nilaynagh8-del/Customizable-PCB-Badge/PCB/Custom PCB Badge.kicad_pcb

## KiCad design PCB/Custom PCB Badge.kicad_pcb (2026-10-25)

Schematic: Custom PCB Badge.kicad_sch

Parts:
C1, C2, C3, C4, C5, C6, C7, C8, C9, C10, C11, C12, C17: 0.1uf; C_0402_1005Metric_Pad0.74x0.62mm_HandSolder
C13, C14, C18: 10uf; C_0603_1608Metric_Pad1.08x0.95mm_HandSolder
C15, C16: 15pf; C_0402_1005Metric_Pad0.74x0.62mm_HandSolder
J1: USB_C_Receptacle_USB2.0_14P; USB_C_Receptacle_HRO_TYPE-C-31-M-12
J3: Conn_01x15_MountingPin; PinHeader_1x15_P2.54mm_Vertical
J8: Conn_01x11_MountingPin; PinHeader_1x11_P2.54mm_Vertical
R1: 5.1K; R_0402_1005Metric_Pad0.72x0.64mm_HandSolder
R2: 5.1k; R_0402_1005Metric_Pad0.72x0.64mm_HandSolder
R3, R4: 27; R_0402_1005Metric_Pad0.72x0.64mm_HandSolder
R5, R6: 1k; R_0402_1005Metric_Pad0.72x0.64mm_HandSolder
R7: 10k; R_0402_1005Metric_Pad0.72x0.64mm_HandSolder
SW1: SW_Push; SW_Push_1P1T_NO_CK_KMR2
U1: RP2040; QFN-56-1EP_7x7mm_P0.4mm_EP3.2x3.2mm
U2: NCP1117-3.3_SOT223; SOT-223-3_TabPin2
U3: W25Q128JVS; SOIC-8_5.3x5.3mm_P1.27mm
Y1: 12mhz; Crystal_SMD_3225-4Pin_3.2x2.5mm_HandSoldering

Connections:
+1V1: C10.1, C11.1, C12.1, U1.43 (ADC_AVDD), U1.48 (USB_VDD)
+3V3: C1.1, C2.1, C3.1, C4.1, C5.1, C6.1, C7.1, C8.1, C9.1, C14.1, C17.1, J3.5, J8.5, R7.1, U1.1 (IOVDD), U1.10 (IOVDD), U1.22 (IOVDD), U1.23 (DVDD), U1.33 (IOVDD), U1.42 (IOVDD), U1.44 (VREG_VIN), U1.45 (VREG_VOUT), U1.49 (IOVDD), U1.50 (DVDD), U2.2 (VO), U3.8 (VCC); also elsewhere on the board
+5V: C13.1, C18.1, J1.A4 (VBUS), J1.A9 (VBUS), J1.B4 (VBUS), J1.B9 (VBUS), J3.1, J8.1, U2.3 (VI)
/d+: J1.A6 (D+), J1.B6 (D+), R3.1
/d-: J1.A7 (D-), J1.B7 (D-), R4.1
/xin: C16.2, U1.20 (XIN), Y1.3
/xout: R5.2, U1.21 (XOUT)
GND: C1.2, C2.2, C3.2, C4.2, C5.2, C6.2, C7.2, C8.2, C9.2, C10.2, C11.2, C12.2, C13.2, C14.2, C15.1, C16.1, C17.2, C18.2, J1.A1 (GND), J1.A12 (GND), J1.B1 (GND), J1.B12 (GND), J1.SH (SHIELD), J3.3, J3.8, J3.13, J8.3, J8.8, J8.10, R1.2, R2.1, SW1.1, U1.19 (TESTEN), U1.57 (GND), U2.1 (GND), U3.4 (GND), Y1.2 (G), Y1.4 (G); also elsewhere on the board
GPIO0: J3.2, U1.2 (GPIO0)
GPIO1: J3.4, U1.3 (GPIO1)
GPIO2: J3.6, U1.4 (GPIO2)
GPIO3: J3.7, U1.5 (GPIO3)
GPIO4: J3.9, U1.6 (GPIO4)
GPIO5: J3.10, U1.7 (GPIO5)
GPIO6: J3.11, U1.8 (GPIO6)
GPIO7: J3.12, U1.9 (GPIO7)
GPIO8: J3.14, U1.11 (GPIO8)
GPIO9: J3.15, U1.12 (GPIO9)
GPIO10: U1.13 (GPIO10); also elsewhere on the board
GPIO11: U1.14 (GPIO11); also elsewhere on the board
GPIO12: U1.15 (GPIO12); also elsewhere on the board
GPIO13: U1.16 (GPIO13); also elsewhere on the board
GPIO14: J8.4, U1.17 (GPIO14)
GPIO15: J8.6, U1.18 (GPIO15)
GPIO16: J8.7, U1.27 (GPIO16)
GPIO17: J8.9, U1.28 (GPIO17)
GPIO18: J8.11, U1.29 (GPIO18)
GPIO19: J8.2, U1.30 (GPIO19)
GPIO20: U1.31 (GPIO20); also elsewhere on the board
GPIO21: U1.32 (GPIO21); also elsewhere on the board
GPIO22: U1.34 (GPIO22); also elsewhere on the board
GPIO23: U1.35 (GPIO23); also elsewhere on the board
GPIO24: U1.36 (GPIO24); also elsewhere on the board
GPIO25: U1.37 (GPIO25); also elsewhere on the board
GPIO26: U1.38 (GPIO26/ADC0); also elsewhere on the board
GPIO27: U1.39 (GPIO27/ADC1); also elsewhere on the board
GPIO28: U1.40 (GPIO28/ADC2); also elsewhere on the board
GPIO29: U1.41 (GPIO29/ADC3); also elsewhere on the board
unnamed: C15.2, R5.1, Y1.1
unnamed: J1.A5 (CC1), R1.1
unnamed: J1.B5 (CC2), R2.2
unnamed: R6.1, SW1.2
unnamed: R3.2, U1.46 (USB_DM)
unnamed: R4.2, U1.47 (USB_DP)
QSPISS: R6.2, R7.2, U1.56 (~QSPI_SS), U3.1 (~CS)
QSPI_SCLK: U1.52 (QSPI_SCLK), U3.6 (CLK)
QSPI_SD0: U1.53 (QSPI_SD0), U3.5 (DI/IO_{0})
QSPI_SD1: U1.55 (QSPI_SD1), U3.2 (DO/IO_{1})
QSPI_SD2: U1.54 (QSPI_SD2), U3.3 (~WP/IO_{2})
QSPI_SD3: U1.51 (QSPI_SD3), U3.7 (~HOLD/~RESET/IO_{3})
RUN: U1.26 (RUN)

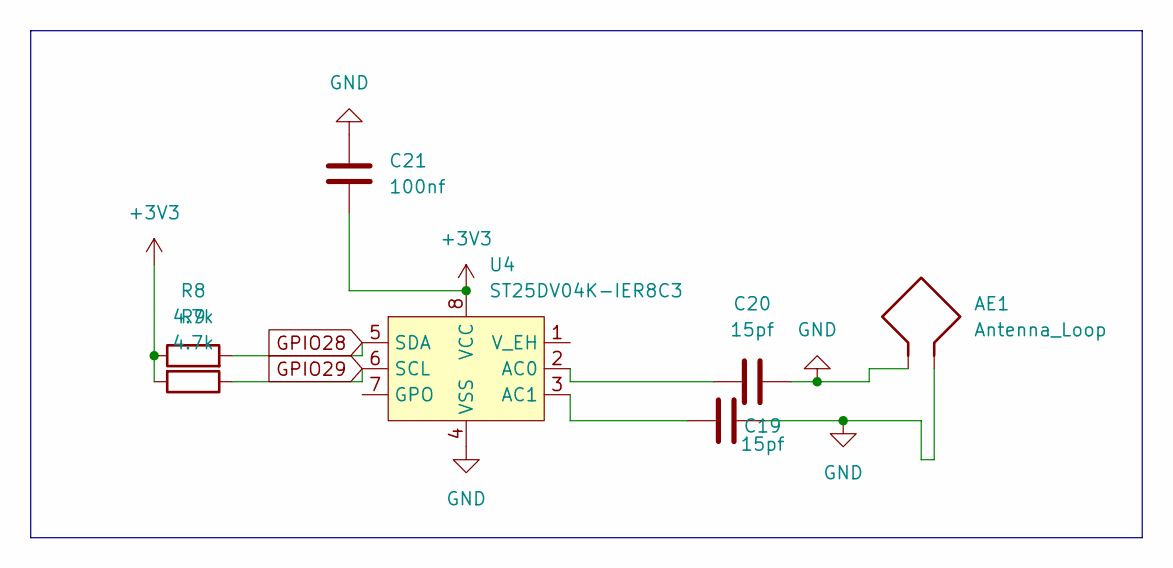
[picture p1: schematic NFC.kicad_sch]

Parts:
AE1: Antenna_Loop; PinHeader_1x02_P2.54mm_Vertical_SMD_Pin1Left
C19, C20: 15pf; C_0402_1005Metric_Pad0.74x0.62mm_HandSolder
C21: 100nf; C_0402_1005Metric_Pad0.74x0.62mm_HandSolder
R8, R9: 4.7k; R_0402_1005Metric_Pad0.72x0.64mm_HandSolder
U4: ST25DV04K-IER8C3; DFN-8-1EP_3x2mm_P0.5mm_EP1.36x1.46mm

Connections:
+3V3: C21.1, R8.1, R9.2, U4.8 (VCC); also elsewhere on the board
GND: AE1.1, AE1.2, C19.2, C20.2, C21.2, U4.4 (VSS); also elsewhere on the board
GPIO28: R8.2, U4.5 (SDA); also elsewhere on the board
GPIO29: R9.1, U4.6 (SCL); also elsewhere on the board
unnamed: C20.1, U4.2 (AC0)
unnamed: C19.1, U4.3 (AC1)

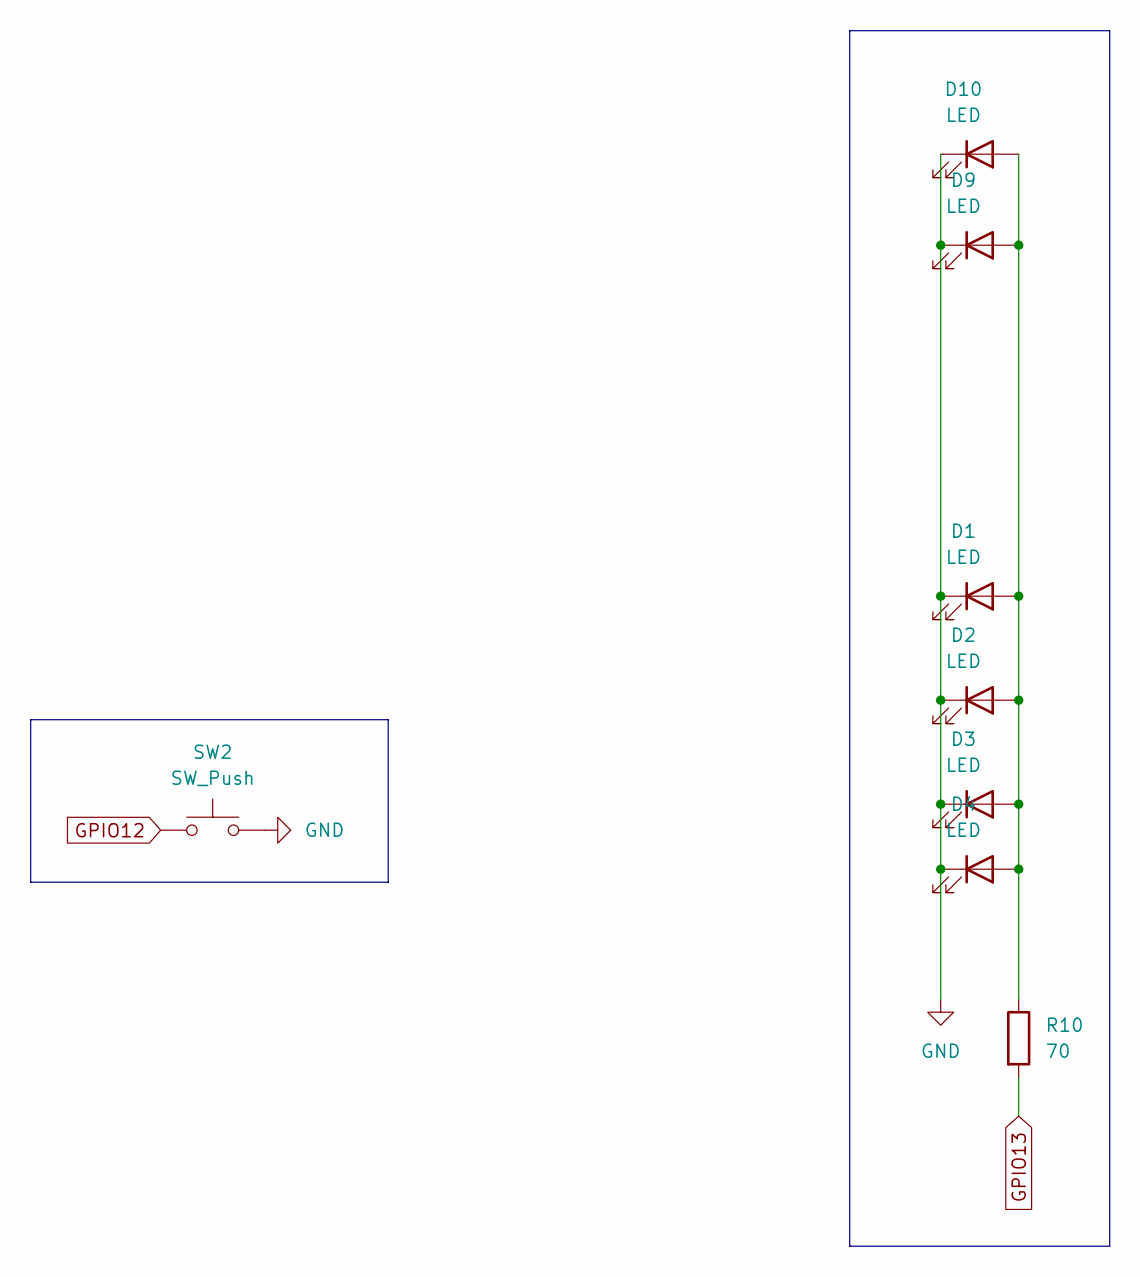
[picture p2: schematic LEDFUN.kicad_sch]

Parts:
D1, D2, D3, D4, D9, D10: LED; LED_D5.0mm
R10: 70; R_0402_1005Metric_Pad0.72x0.64mm_HandSolder
SW2: SW_Push; SW_SPST_PTS645Sx43SMTR92

Connections:
GND: D1.1 (K), D2.1 (K), D3.1 (K), D4.1 (K), D9.1 (K), D10.1 (K), SW2.2; also elsewhere on the board
GPIO12: SW2.1; also elsewhere on the board
GPIO13: R10.2; also elsewhere on the board
unnamed: D1.2 (A), D2.2 (A), D3.2 (A), D4.2 (A), D9.2 (A), D10.2 (A), R10.1

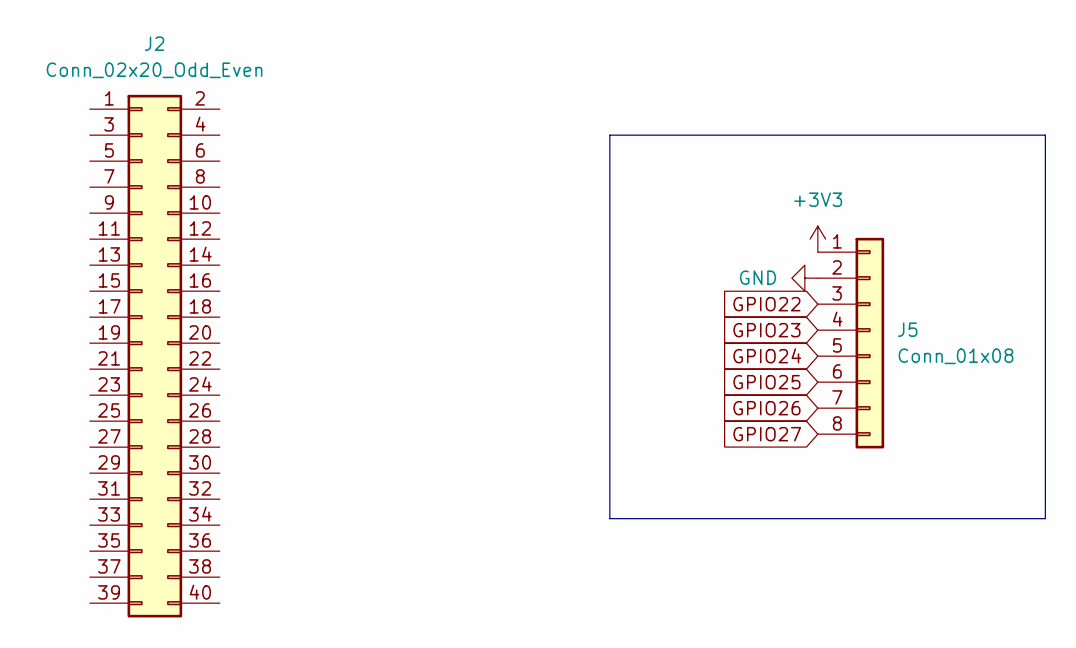
[picture p3: schematic untitled.kicad_sch]

Parts:
J2: Conn_02x20_Odd_Even; PinHeader_2x20_P2.54mm_Vertical
J5: Conn_01x08; PinHeader_1x08_P2.54mm_Vertical

Connections:
+3V3: J5.1; also elsewhere on the board
GND: J5.2; also elsewhere on the board
GPIO22: J5.3; also elsewhere on the board
GPIO23: J5.4; also elsewhere on the board
GPIO24: J5.5; also elsewhere on the board
GPIO25: J5.6; also elsewhere on the board
GPIO26: J5.7; also elsewhere on the board
GPIO27: J5.8; also elsewhere on the board

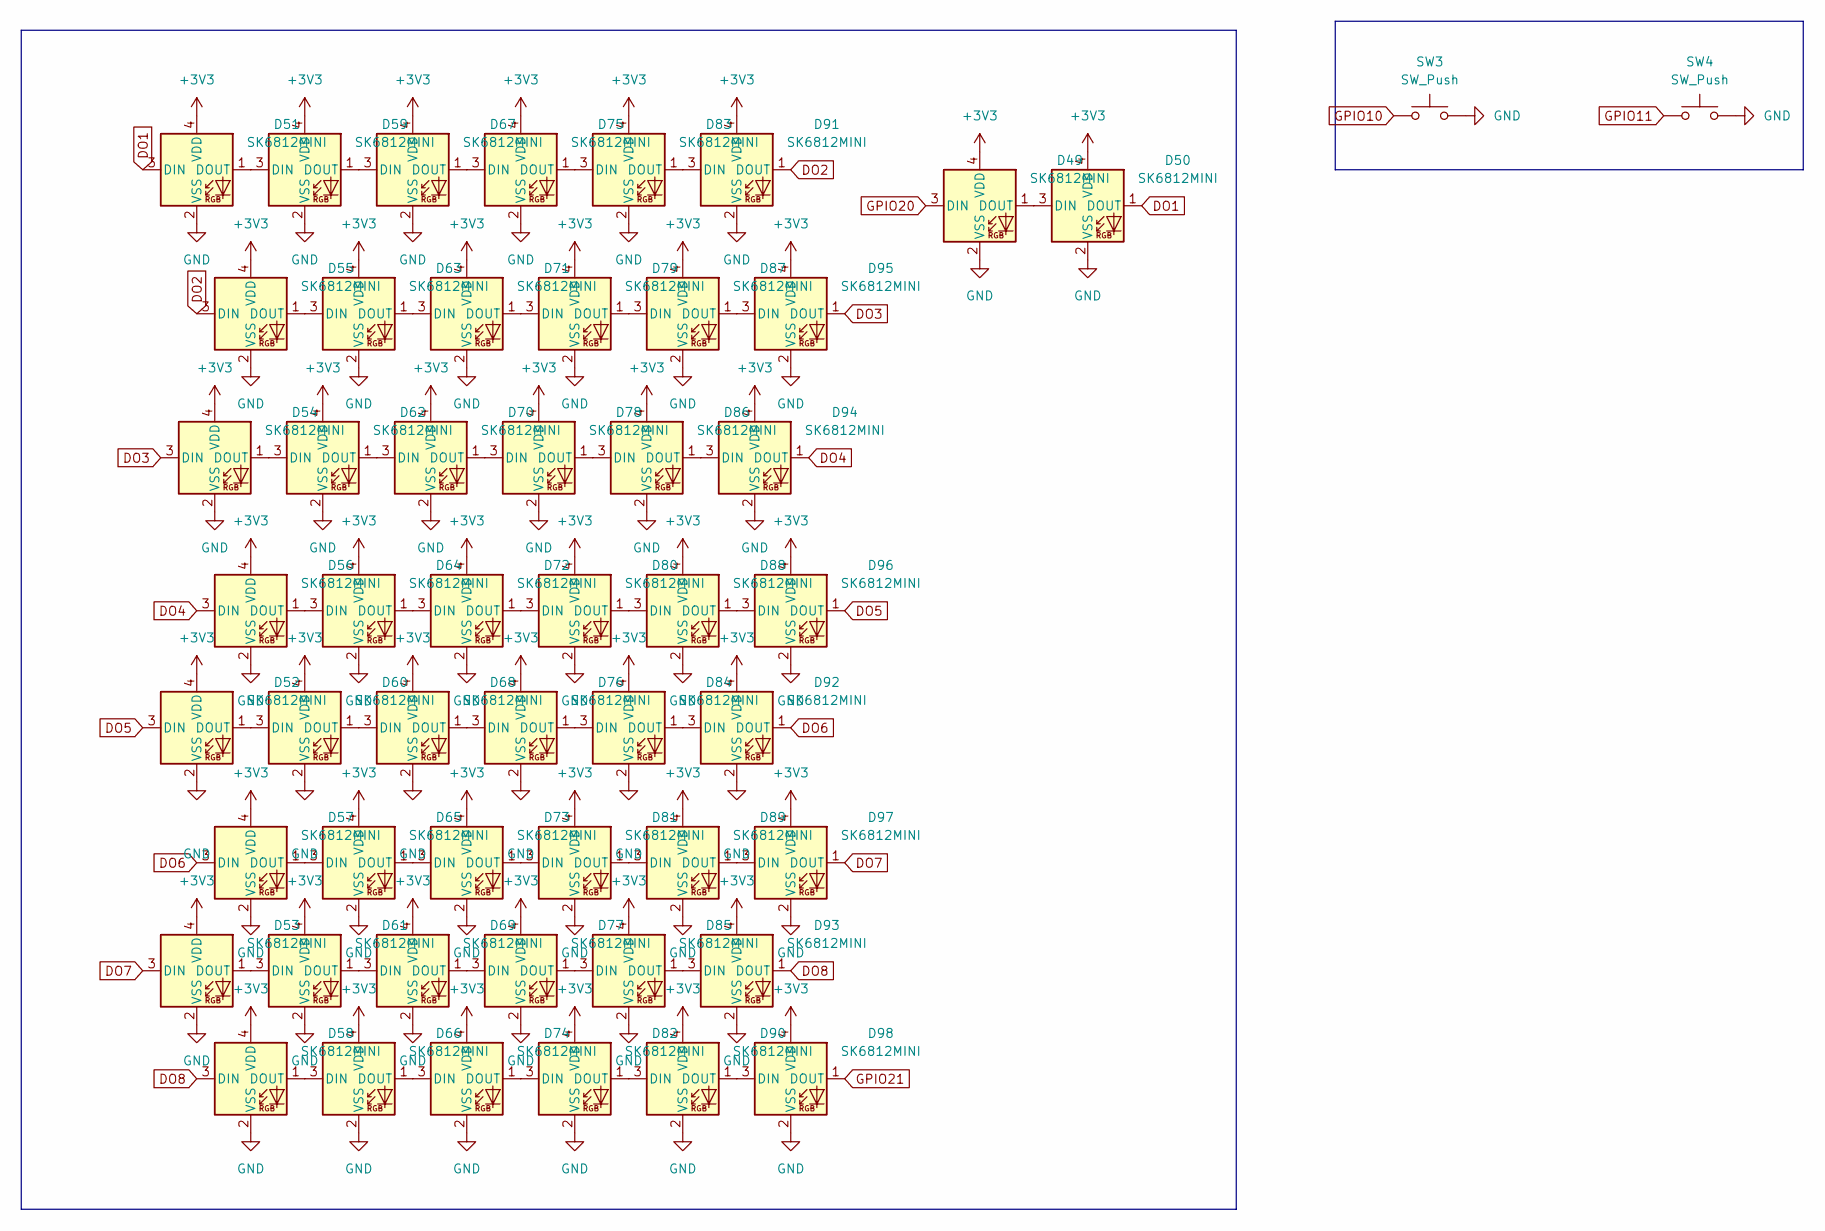
[picture p4: schematic pcbbadgeLEDS.kicad_sch]

Parts:
D49, D50, D51, D52, D53, D54, D55, D56, D57, D58, D59, D60, D61, D62, D63, D64, D65, D66, D67, D68, D69, D70, D71, D72, D73, D74, D75, D76, D77, D78, D79, D80, D81, D82, D83, D84, D85, D86, D87, D88, D89, D90, D91, D92, D93, D94, D95, D96, D97, D98: SK6812MINI; LED_SK6812MINI_PLCC4_3.5x3.5mm_P1.75mm
SW3, SW4: SW_Push; SW_SPST_PTS645Sx43SMTR92

Connections:
+3V3: D49.4 (VDD), D50.4 (VDD), D51.4 (VDD), D52.4 (VDD), D53.4 (VDD), D54.4 (VDD), D55.4 (VDD), D56.4 (VDD), D57.4 (VDD), D58.4 (VDD), D59.4 (VDD), D60.4 (VDD), D61.4 (VDD), D62.4 (VDD), D63.4 (VDD), D64.4 (VDD), D65.4 (VDD), D66.4 (VDD), D67.4 (VDD), D68.4 (VDD), D69.4 (VDD), D70.4 (VDD), D71.4 (VDD), D72.4 (VDD), D73.4 (VDD), D74.4 (VDD), D75.4 (VDD), D76.4 (VDD), D77.4 (VDD), D78.4 (VDD), D79.4 (VDD), D80.4 (VDD), D81.4 (VDD), D82.4 (VDD), D83.4 (VDD), D84.4 (VDD), D85.4 (VDD), D86.4 (VDD), D87.4 (VDD), D88.4 (VDD), D89.4 (VDD), D90.4 (VDD), D91.4 (VDD), D92.4 (VDD), D93.4 (VDD), D94.4 (VDD), D95.4 (VDD), D96.4 (VDD), D97.4 (VDD), D98.4 (VDD); also elsewhere on the board
DO1: D50.1 (DOUT), D51.3 (DIN)
DO2: D55.3 (DIN), D91.1 (DOUT)
DO3: D54.3 (DIN), D95.1 (DOUT)
DO4: D56.3 (DIN), D94.1 (DOUT)
DO5: D52.3 (DIN), D96.1 (DOUT)
DO6: D57.3 (DIN), D92.1 (DOUT)
DO7: D53.3 (DIN), D97.1 (DOUT)
DO8: D58.3 (DIN), D93.1 (DOUT)
GND: D49.2 (VSS), D50.2 (VSS), D51.2 (VSS), D52.2 (VSS), D53.2 (VSS), D54.2 (VSS), D55.2 (VSS), D56.2 (VSS), D57.2 (VSS), D58.2 (VSS), D59.2 (VSS), D60.2 (VSS), D61.2 (VSS), D62.2 (VSS), D63.2 (VSS), D64.2 (VSS), D65.2 (VSS), D66.2 (VSS), D67.2 (VSS), D68.2 (VSS), D69.2 (VSS), D70.2 (VSS), D71.2 (VSS), D72.2 (VSS), D73.2 (VSS), D74.2 (VSS), D75.2 (VSS), D76.2 (VSS), D77.2 (VSS), D78.2 (VSS), D79.2 (VSS), D80.2 (VSS), D81.2 (VSS), D82.2 (VSS), D83.2 (VSS), D84.2 (VSS), D85.2 (VSS), D86.2 (VSS), D87.2 (VSS), D88.2 (VSS), D89.2 (VSS), D90.2 (VSS), D91.2 (VSS), D92.2 (VSS), D93.2 (VSS), D94.2 (VSS), D95.2 (VSS), D96.2 (VSS), D97.2 (VSS), D98.2 (VSS), SW3.2, SW4.2; also elsewhere on the board
GPIO10: SW3.1; also elsewhere on the board
GPIO11: SW4.1; also elsewhere on the board
GPIO20: D49.3 (DIN); also elsewhere on the board
GPIO21: D98.1 (DOUT); also elsewhere on the board
unnamed: D49.1 (DOUT), D50.3 (DIN)
unnamed: D51.1 (DOUT), D59.3 (DIN)
unnamed: D52.1 (DOUT), D60.3 (DIN)
unnamed: D53.1 (DOUT), D61.3 (DIN)
unnamed: D54.1 (DOUT), D62.3 (DIN)
unnamed: D55.1 (DOUT), D63.3 (DIN)
unnamed: D56.1 (DOUT), D64.3 (DIN)
unnamed: D57.1 (DOUT), D65.3 (DIN)
unnamed: D58.1 (DOUT), D66.3 (DIN)
unnamed: D59.1 (DOUT), D67.3 (DIN)
unnamed: D60.1 (DOUT), D68.3 (DIN)
unnamed: D61.1 (DOUT), D69.3 (DIN)
unnamed: D62.1 (DOUT), D70.3 (DIN)
unnamed: D63.1 (DOUT), D71.3 (DIN)
unnamed: D64.1 (DOUT), D72.3 (DIN)
unnamed: D65.1 (DOUT), D73.3 (DIN)
unnamed: D66.1 (DOUT), D74.3 (DIN)
unnamed: D67.1 (DOUT), D75.3 (DIN)
unnamed: D68.1 (DOUT), D76.3 (DIN)
unnamed: D69.1 (DOUT), D77.3 (DIN)
unnamed: D70.1 (DOUT), D78.3 (DIN)
unnamed: D71.1 (DOUT), D79.3 (DIN)
unnamed: D72.1 (DOUT), D80.3 (DIN)
unnamed: D73.1 (DOUT), D81.3 (DIN)
unnamed: D74.1 (DOUT), D82.3 (DIN)
unnamed: D75.1 (DOUT), D83.3 (DIN)
unnamed: D76.1 (DOUT), D84.3 (DIN)
unnamed: D77.1 (DOUT), D85.3 (DIN)
unnamed: D78.1 (DOUT), D86.3 (DIN)
unnamed: D79.1 (DOUT), D87.3 (DIN)
unnamed: D80.1 (DOUT), D88.3 (DIN)
unnamed: D81.1 (DOUT), D89.3 (DIN)
unnamed: D82.1 (DOUT), D90.3 (DIN)
unnamed: D83.1 (DOUT), D91.3 (DIN)
unnamed: D84.1 (DOUT), D92.3 (DIN)
unnamed: D85.1 (DOUT), D93.3 (DIN)
unnamed: D86.1 (DOUT), D94.3 (DIN)
unnamed: D87.1 (DOUT), D95.3 (DIN)
unnamed: D88.1 (DOUT), D96.3 (DIN)
unnamed: D89.1 (DOUT), D97.3 (DIN)
unnamed: D90.1 (DOUT), D98.3 (DIN)

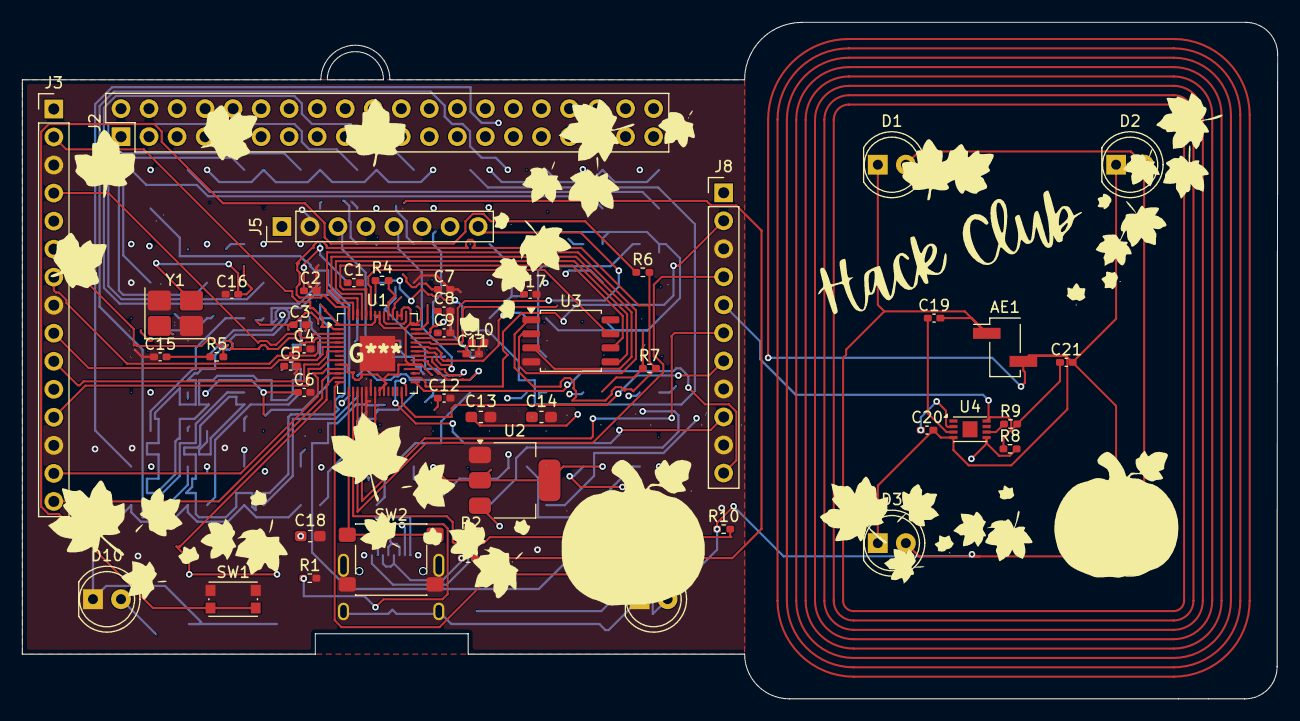
[picture p5: board Custom PCB Badge.kicad_pcb from above]

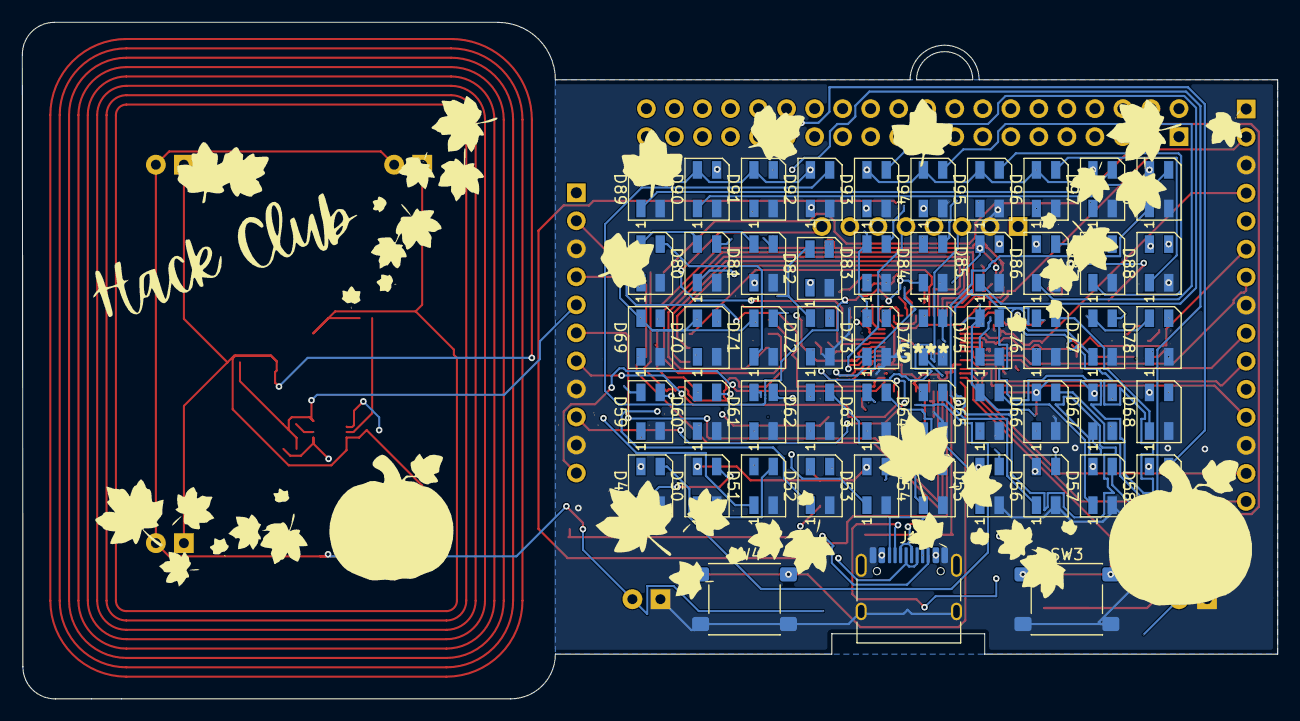
[picture p6: board Custom PCB Badge.kicad_pcb from below]

Board: 6 copper layers, 113.7 x 61.3 mm, 102 parts (53 on the bottom side), 102 nets.
