nilaynagh8-del/Customizable-PCB-Badge/(commit log)

2026-10-25 Update component prices in README BOM
    Updated component prices in the BOM section of the README.
2026-10-25 Fix formatting of capacitor link in README
2026-10-25 Revise BOM quantities and prices in README
    Updated component quantities and prices in the BOM section.
